masbando/maiana/latest/CAD/Board-12.0.1/transponder-12.0.1.step

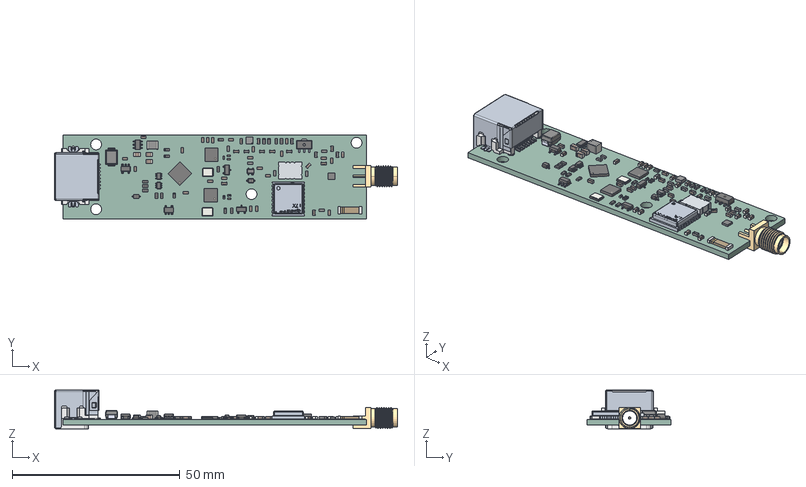
[picture p1: CAD file, 2025-10-12]
latest/CAD/Board-12.0.1/transponder-12.0.1.step
102.2 x 25.0 x 11.6 mm
1KSMB100CA
C_0603_1608Metric x 32
PSA4-5043+
ASSEMBLY
L_0603_1608Metric x 12
R_0603_1608Metric x 16
Crystal_SMD_3225-4Pin_3.2x2.5mm x 2
SOT_363_SC_70_6 x 2
L_0402_1005Metric x 2
L_1210_3225Metric
SOT_23 x 2
L76-L
C_0402_1005Metric x 4
D_SOD_323 x 2
QFN-32-1EP_5x5mm_Pitch0.5mm
C_0805_2012Metric x 3
QFN_20_1EP_4x4mm_P05mm x 2
TSOT_23_6
CON-SMA-EDGE-S
SOT_23_5 x 2
CQ assembly
RJ-82A86MMNL
transponder-12.0.1_PCB
