masbando/maiana/(commit log)

2025-10-12 Added board 12.0.1 CAD
    [connections.kicad_sch, gnss.kicad_sch, mcu.kicad_sch, power.kicad_sch, radio.kicad_sch, rx.kicad_sch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]
2025-10-12 N2K adapter and firmware project update
    [NMEA2000Adapter-8.1.kicad_pcb, transponder-11.9.1.kicad_pcb]
