masbando/maiana/(notices)

Notices in the files:
latest/CAD/NMEA2000Breakout/Rev8.1/NMEA2000Adapter-8.1.kicad_pcb:
(c)2023 Maverick Labs LLC
